ajvdw/EMSBusShield/README.md

# EMSBusShield

This board uses EMS-ESP32 with the following configuration

EMS-ESP32 (https://github.com/emsesp/EMS-ESP32)

Board Profile: Custom
Rx GPIO: 18
Tx GPIO: 19
Button GPIO: 0
Temperature GPIO: 0
Led GPIO: 2
