ajvdw/EMSBusShield/media/EMSBUS.pdf

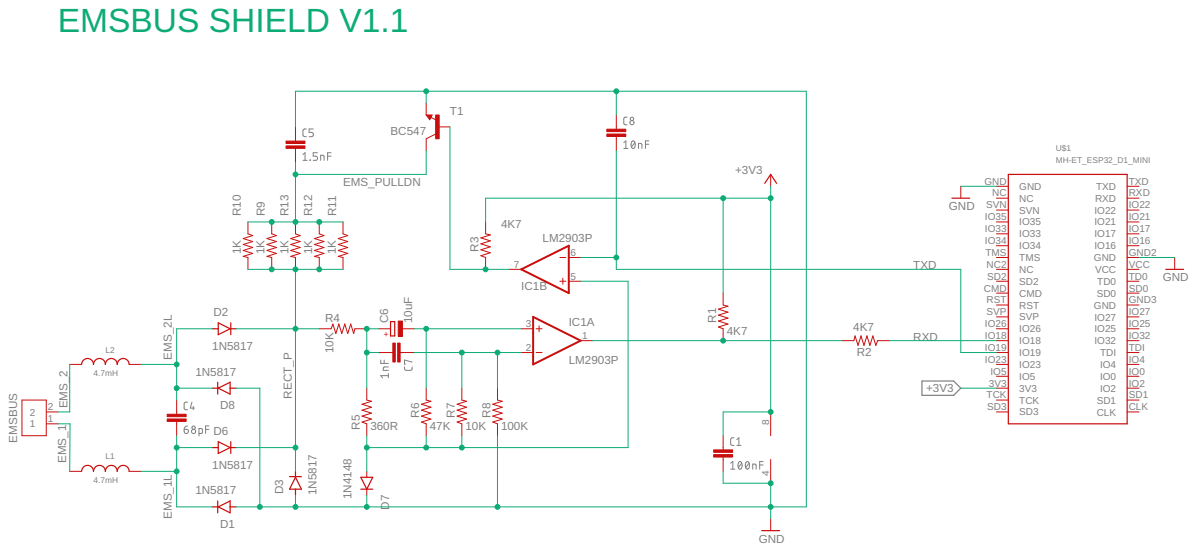
[picture p1: page 1]
