ajvdw/EMSBusShield/eagle/EMSBUS.brd

## EAGLE design eagle/EMSBUS.brd (2022-08-01)

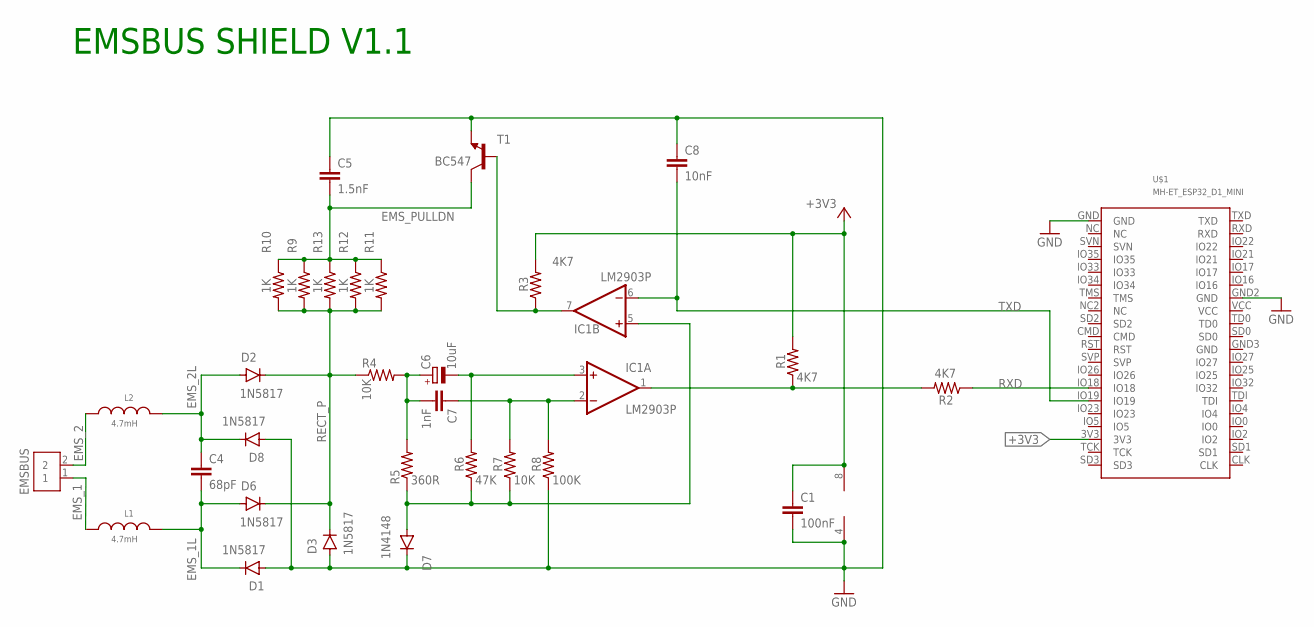
[picture p2: schematic EMSBUS.sch]

Parts:
C1: 100nF; CAP-PTH-2.54
C4: 68pF; CAP-PTH-2.54
C5: 1.5nF; CAP-PTH-2.54
C6: 10uF; E5-8,5
C7: 1nF; CAP-PTH-2.54
C8: 10nF; CAP-PTH-2.54
D1, D2, D3, D6, D8: 1N5817; DO-41
D7: 1N4148; DIODE-1N4148
EMSBUS: 2828XX-2282837-2; TERMBLK_508-2N
IC1: LM2903P; DIL08
L1, L2: 4.7mH; WE-FAMI_8010_744750230030
R1, R2, R3: 4K7; 0204/7
R4, R7: 10K; 0204/7
R5: 360R; 0204/7
R6: 47K; 0204/7
R8: 100K; 0204/7
R9, R10, R11, R12, R13: 1K; 0204/7
T1: BC547; TO92
U$1: MH-ET_ESP32_D1_MINI

Connections:
+3V3: C1.1, IC1.8 (V+), R1.2, R3.2, U$1.3V3
EMS_1: EMSBUS.1, L1.1
EMS_1L: C4.2, D1.C, D6.A, L1.2
EMS_2: EMSBUS.2, L2.1
EMS_2L: C4.1, D2.A, D8.C, L2.2
EMS_PULLDN: C5.2, R9.1, R10.1, R11.1, R12.1, R13.1, T1.3 (C)
GND: C1.2, C5.1, C8.1, D1.A, D3.A, D7.C, D8.A, IC1.4 (V-), R8.1, T1.1 (E), U$1.GND, U$1.GND2 (GND)
unnamed: IC1.7 (OUT), R3.1, T1.2 (B)
unnamed: IC1.1 (OUT), R1.1, R2.2
unnamed: D7.A, IC1.5 (+IN), R5.1, R6.1, R7.1
unnamed: C6.+, C7.2, R4.2, R5.2
unnamed: C7.1, IC1.2 (-IN), R7.2, R8.2
unnamed: C6.-, IC1.3 (+IN), R6.2
RECT_P: D2.C, D3.C, D6.C, R4.1, R9.2, R10.2, R11.2, R12.2, R13.2
RXD: R2.1, U$1.IO18
TXD: C8.2, IC1.6 (-IN), U$1.IO19

Notes on the sheet:
EMSBUS SHIELD V1.1

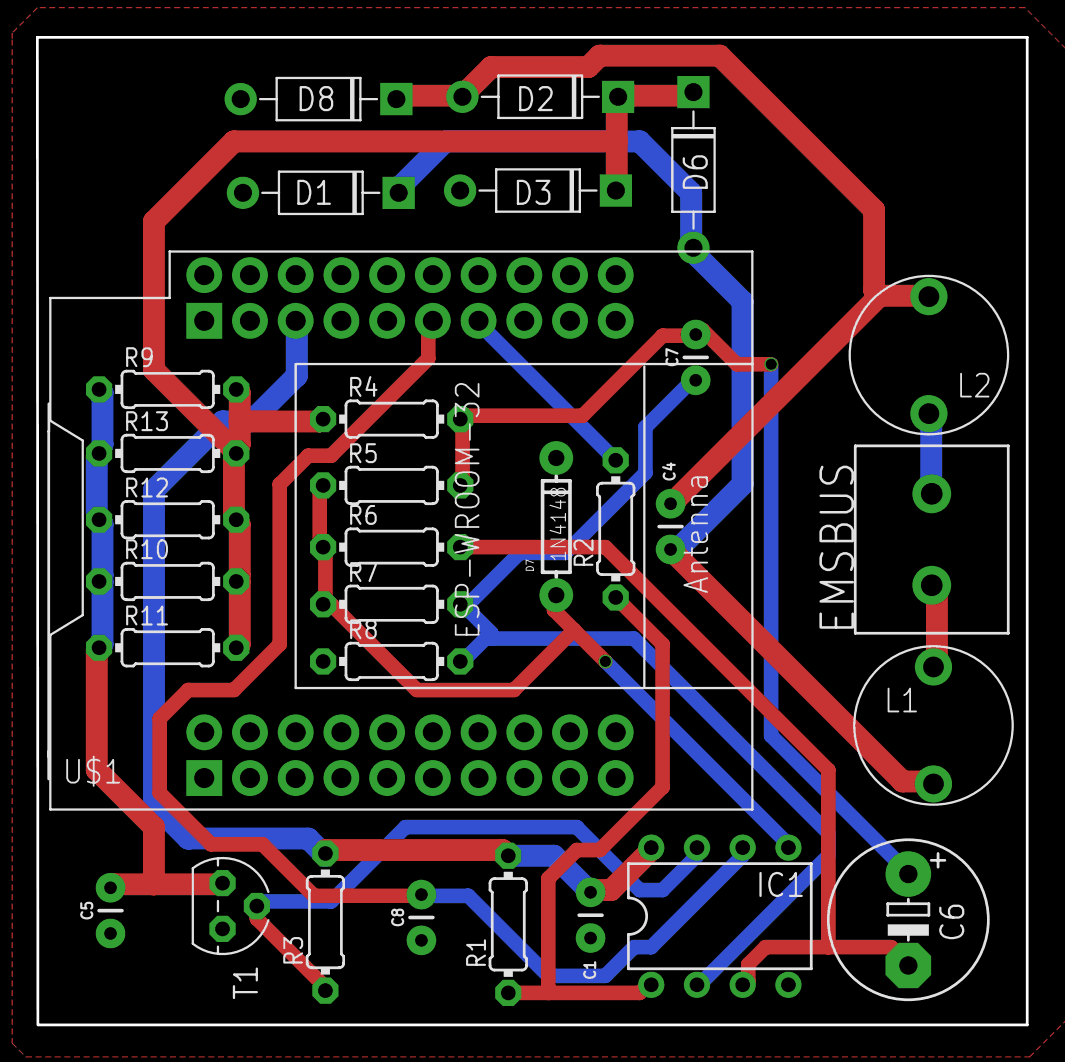
[picture p3: board EMSBUS.brd from above]

Board: 2 copper layers, 55.0 x 54.9 mm, 31 parts (0 on the bottom side), 16 nets.
