ajvdw/EMSBusShield/(threads)

Thread 1 (2022-11-06):

Maximum voltage for powering the board

luky133, 2022-11-06:
I have question about max voltage for powering the board. I used my lab power supply and if I set-up voltage to 12V an ESP board is bricked after few second (I can’t connect to ESP-EMS via Wi-Fi). If I used voltage between 7-9V ESP board working. I measured voltage on 78L05 and there is still 5V, but if I used 12V 78L05  is too hot (+70°C). Is this a bug or a feature?

ajvdw, 2022-11-06:
It depends on the esp board. A Lolin ESP32 S2 only supports max 5V on the VBUS. Most boards have a max of 5V input.

Just power the board through the USB port and it should work fine.
Typically a 78L05  is not powerful enough to power a board in AP mode.
The conversion from 12 to 5 is often done by dissipating the heat .....

If you want 12V as an input, use a step down dc dc converter (https://www.aliexpress.com/item/1005001621785349.html).

Closed 2022-11-06.

Thread 2 (2023-01-20):

Success story with this EMS Bus Shield!

richardvandentoorn, 2023-01-20:
Hello World,

For anyone who would like to know if this EMS Bus Shield is working, I can confirm that it works flawlessly with the [EMS-ESP](https://emsesp.github.io/docs/) firmware. I have connected it to an old Nefit TopLine boiler, with a Moduline 400 thermostat and all communication is working properly!

Big thanks to Arie Johan for providing this GitHub repository including the Gerber files to be able to manufacture the PCB

Here were the steps involved for me:

1. Create the PCB by uploading the [zip file with the gerbers](https://github.com/ajvdw/EMSBusShield/blob/main/eagle/gerbers/EMSBUS_2022-08-01.zip)  to a PCB manufacturer. I used JLCPCB, but I guess PcbWay also works. It didn't cost that much, for about 10 Euros, you can get 5 PCB's. Excellent

2. Order the parts, e.g by Reichelt. I don't think it's very critical, but most (if not all) parts are so common that you get it delivered in a couple of days. Do not forget to also order the 2x10 pin headers for the D1 mini

3. Solder it together. I just my beloved 25 year old WECP-20, with normal soldering skills. I soldered all the pins of the 2x10 bus header, but I don't think all of them are needed.

4. Order your D1 mini ESP32 from somewhere. [This device at AliExpress](https://nl.aliexpress.com/item/1005004005628679.html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) worked for me. Solder the pin headers onto the device.

5. Flash the ESP-Home firmware. I used the esptool commandline on a Linux device, after downloading the bin files involved. the bin files for esphome can be found [here](https://github.com/emsesp/EMS-ESP32/tree/main/scripts), and flash the stable or development version

6. Configure ESP-Home (it's one the site). Configure it to connect to your Wifi network, and DO NOT FORGET to put the custom pin configuration in the settings. It's also on the README.MD on this repository, but I naively hoped it would work out of the box. If the blue led keeps blinking once, that might be the reason!

7. Connect to wires to your Boiler (I connected to the thermostat header), and browse the EMS-ESP site that your ESP32 exposes.

Play around with it and enjoy!

Good luck!

Richard

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

proddy, 2023-01-20:
Cool! You mentioned ESP-Home but think you meant EMS-ESP :-)

richardvandentoorn, 2023-01-20:
> Cool! You mentioned ESP-Home but think you meant EMS-ESP :-)

Thanks proddy, corrected that!

Thread 3 (2023-08-02):

L1 and L2 inductance values

olegtarasov, 2023-08-02:
Hi!

Thank you for your project! I'm looking to build the shield, but I'm not sure about L1 and L2 inductance values. In the original schematics at https://emsesp.github.io/docs/EMS-Circuit/#a-breadboard-prototype they have 4.7**uH** inductances, and your schematic has 4.7 **mH**. Is this correct? Or the difference doesn't matter much?

Thank you!

ajvdw, 2023-08-02:
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

You are right! I checked, I ordered the 4.7uH inductors. I will change the design accordingly. Slight issue: I used to work with eagle and was more or less forced by autodesk to switch to Kicad...

olegtarasov, 2023-08-02:
Thank you for a quick response! I will just get 4.7uH then :)

Closed 2023-08-02.
