ajvdw/EMSBusShield/(notices)

Notices in the files:
parts and their libraries:
SparkFun-Capacitors: Licensing: Creative Commons ShareAlike 4.0 International - https://creativecommons.org/licenses/by-sa/4.0
Wurth_Elektronik_Passive_rev19e: Copyright: Würth Elektronik
